andrew-davie/NBTV/README.md

# NBTV
Source code for Arduino Micro Mechanical Television
see https://www.taswegian.com/NBTV/forum/viewforum.php?f=28
