andrew-davie/NBTV/src/tv2d.brd

## EAGLE design src/tv2d.brd (2017-06-04)

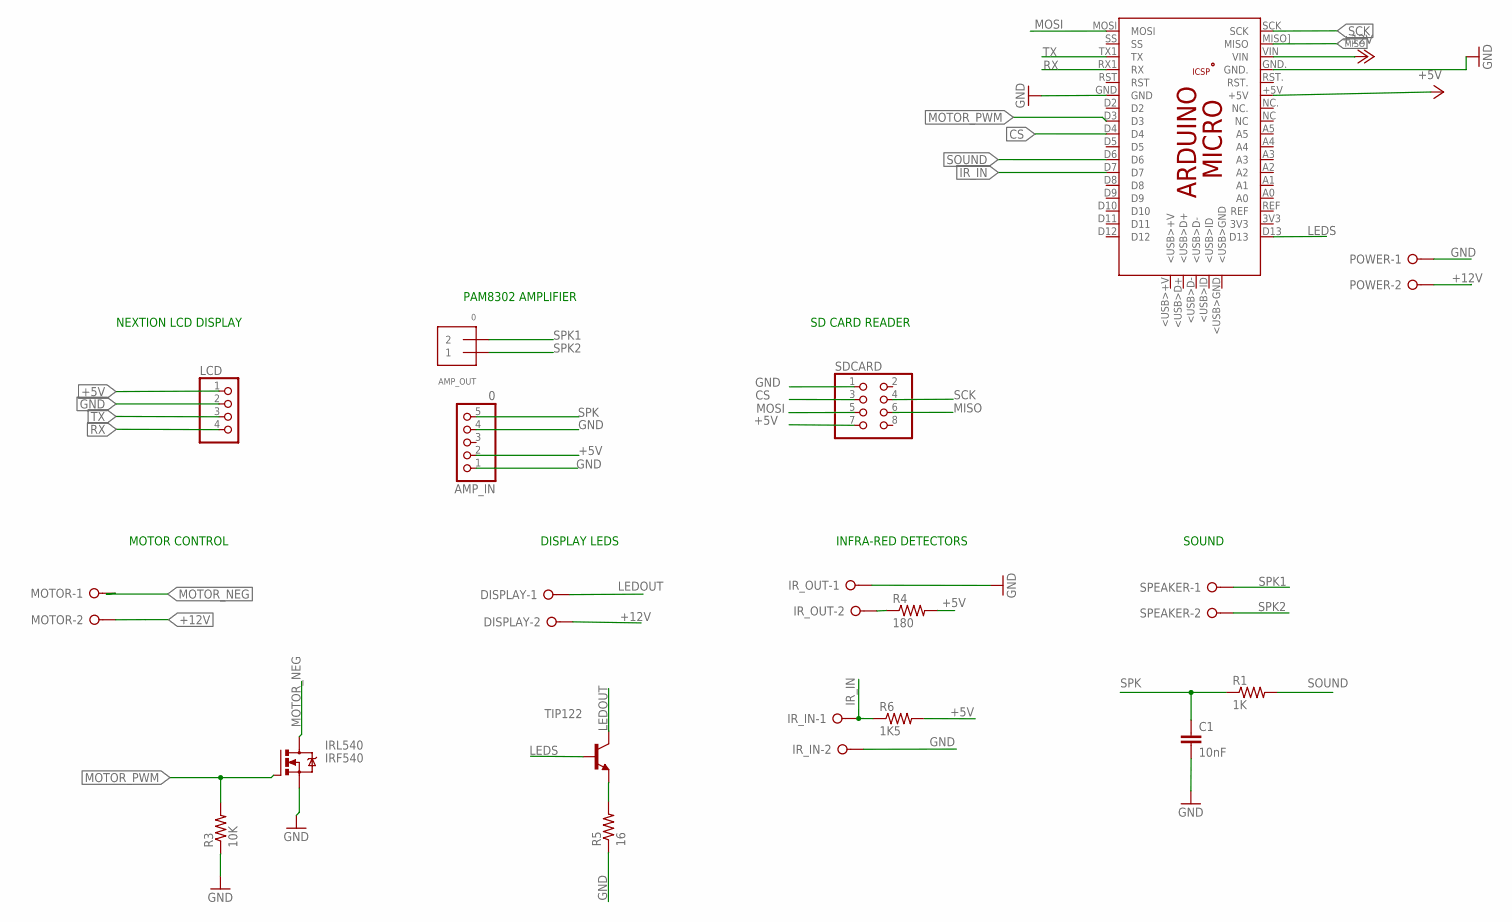
[picture p1: schematic tv2d.sch]

Parts:
AMP_IN: 0; 1X05_ROUND_70
AMP_OUT: 0; TERMBLOCK_1X2-3.5MM
C1: 10nF; C2.5-2
DISPLAY: W237-02P; W237-132
IRL540: IRF540; TO220BV
IR_IN: W237-02P; W237-132
IR_OUT: W237-02P; W237-132
LCD: PINHD-1X4; 1X04
MOTOR: W237-02P; W237-132
PCB1: ARDUINO_MICRO
POWER: W237-02P; W237-132
R1: 1K; 0207/10
R3: 10K; 0207/10
R4: 180; 0207/10
R5: 16; 0207/10
R6: 1K5; 0207/10
SDCARD: PINHD-2X4; 2X04
SPEAKER: W237-02P; W237-132
TIP122: -NPN-TO220V; TO220V

Connections:
+5V: AMP_IN.2, LCD.1, PCB1.+5V, R4.2, R6.2, SDCARD.7
+12V: DISPLAY.2, MOTOR.2, PCB1.VIN, POWER.2
CS: PCB1.D4, SDCARD.3
GND: AMP_IN.1, AMP_IN.4, C1.2, IRL540.S, IR_IN.2, IR_OUT.1, LCD.2, PCB1.GND, PCB1.GND., POWER.1, R3.1, R5.1, SDCARD.1
IR_IN: IR_IN.1, PCB1.D7, R6.1
IR_OUT: IR_OUT.2, R4.1
LEDOUT: DISPLAY.1, TIP122.2 (C)
LEDS: PCB1.D13, TIP122.1 (B)
MISO: PCB1.MISO] (MISO), SDCARD.6
MOSI: PCB1.MOSI, SDCARD.5
MOTOR_NEG: IRL540.D, MOTOR.1
MOTOR_PWM: IRL540.G, PCB1.D3, R3.2
unnamed: R5.2, TIP122.3 (E)
RX: LCD.4, PCB1.RX1 (RX)
SCK: PCB1.SCK, SDCARD.4
SOUND: PCB1.D6, R1.2
SPK: AMP_IN.5, C1.1, R1.1
SPK1: AMP_OUT.2, SPEAKER.1
SPK2: AMP_OUT.1, SPEAKER.2
TX: LCD.3, PCB1.TX1 (TX)

Notes on the sheet:
MOTOR CONTROL
DISPLAY LEDS
INFRA-RED DETECTORS
NEXTION LCD DISPLAY
PAM8302 AMPLIFIER
SD CARD READER
SOUND

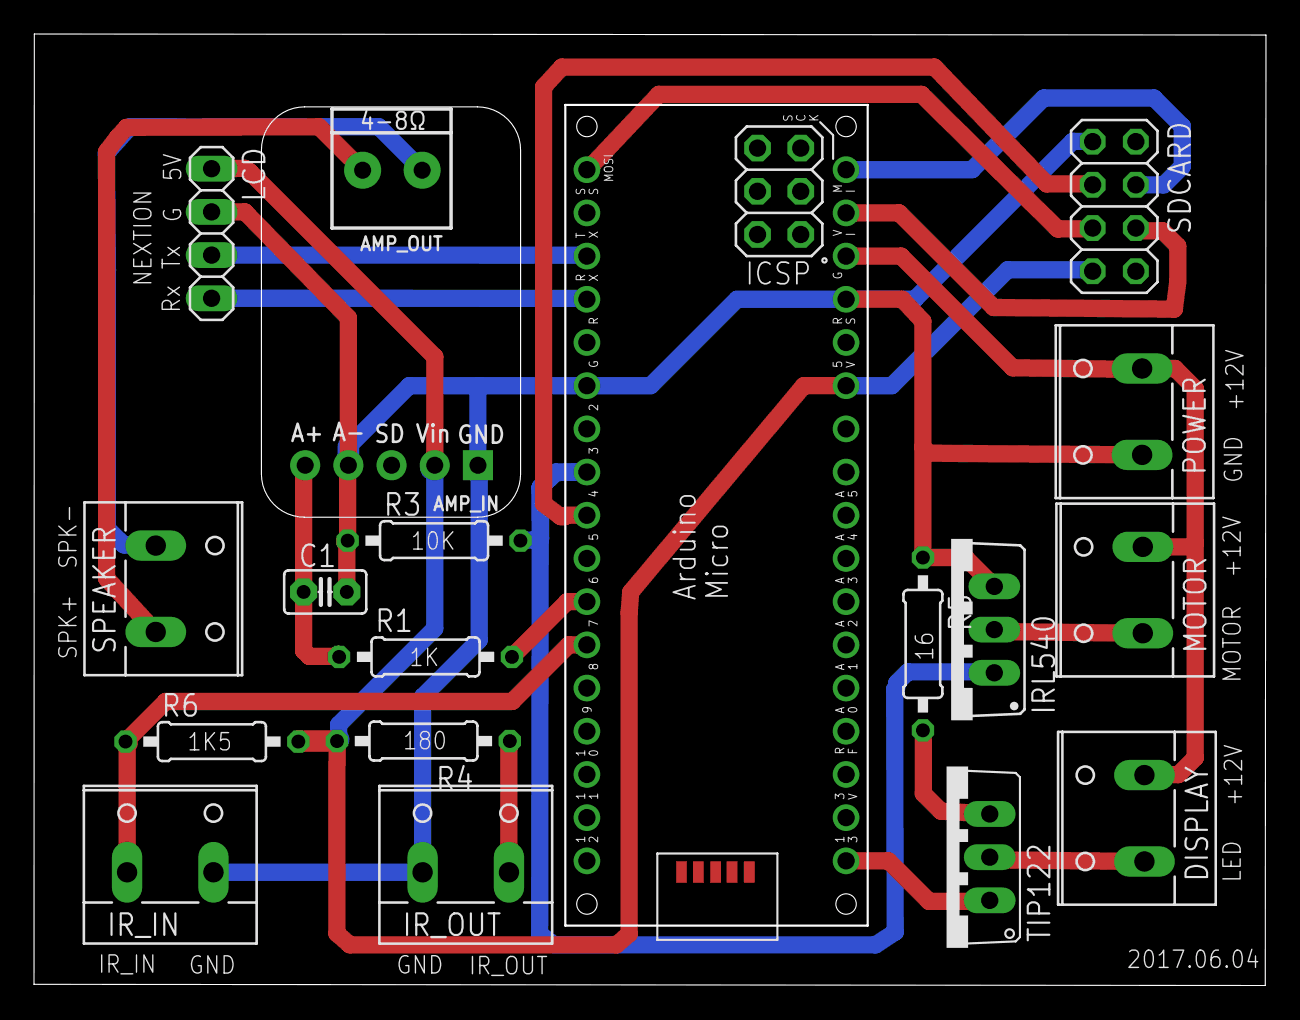
[picture p2: board tv2d.brd from above]

Board: 2 copper layers, 72.4 x 55.9 mm, 19 parts (0 on the bottom side), 20 nets.
