andrew-davie/NBTV/src/tvp3.brd

## EAGLE design src/tvp3.brd (2017-07-02)

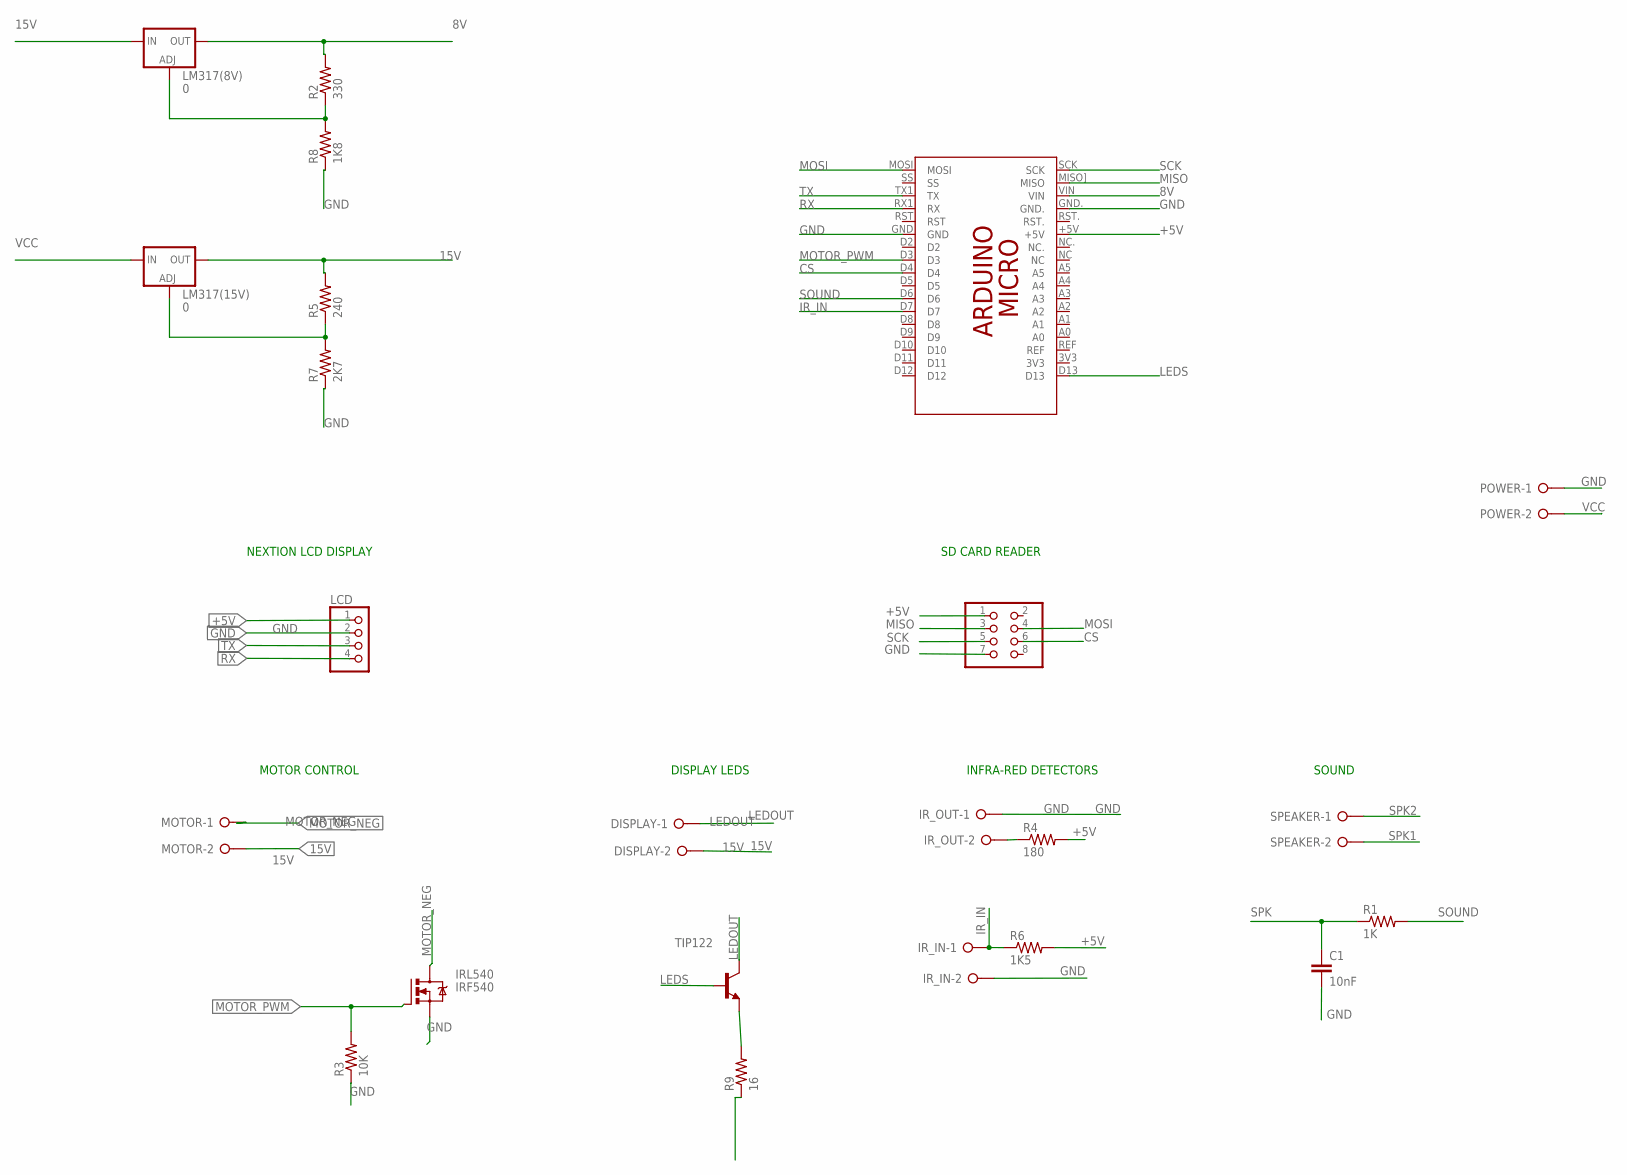
[picture p3: schematic tvp3.sch, sheet 1]

Parts:
C1: 10nF; C2.5-2
DISPLAY: W237-02P; W237-132
IRL540: IRF540; TO220BV
IR_IN: W237-02P; W237-132
IR_OUT: W237-02P; W237-132
LCD: PINHD-1X4; 1X04
LM317(8V), LM317(15V): 0; 317TS
MOTOR: W237-02P; W237-132
PCB2: ARDUINO_MICRO
POWER: W237-02P; W237-132
R1: 1K; 0207/10
R2: 330; 0207/10
R3: 10K; 0207/10
R4: 180; 0207/10
R5: 240; 0207/10
R6: 1K5; 0207/10
R7: 2K7; 0207/10
R8: 1K8; 0207/10
R9: 16; 0207/10
SPEAKER: W237-02P; W237-132
TIP122: -NPN-TO220V; TO220V
_: PINHD-2X4; 2X04

Connections:
8V: LM317(8V).2 (OUT), PCB2.VIN, R2.2
15V: DISPLAY.2, LM317(8V).3 (IN), LM317(15V).2 (OUT), MOTOR.2, R5.2
+5V: LCD.1, PCB2.+5V, R4.2, R6.2, _.1; also elsewhere on the board
CS: PCB2.D4, _.6
GND: C1.2, IRL540.S, IR_IN.2, IR_OUT.1, LCD.2, PCB2.GND, PCB2.GND., POWER.1, R3.1, R7.1, R8.1, R9.1, _.7; also elsewhere on the board
IR_IN: IR_IN.1, PCB2.D7, R6.1
IR_OUT: IR_OUT.2, R4.1
LEDOUT: DISPLAY.1, TIP122.2 (C)
LEDS: PCB2.D13, TIP122.1 (B)
MISO: PCB2.MISO] (MISO), _.3
MOSI: PCB2.MOSI, _.4
MOTOR_NEG: IRL540.D, MOTOR.1
MOTOR_PWM: IRL540.G, PCB2.D3, R3.2
unnamed: LM317(15V).1 (ADJ), R5.1, R7.2
unnamed: R9.2, TIP122.3 (E)
unnamed: LM317(8V).1 (ADJ), R2.1, R8.2
RX: LCD.4, PCB2.RX1 (RX)
SCK: PCB2.SCK, _.5
SOUND: PCB2.D6, R1.2
SPK: C1.1, R1.1; also elsewhere on the board
SPK1: SPEAKER.2; also elsewhere on the board
SPK2: SPEAKER.1; also elsewhere on the board
TX: LCD.3, PCB2.TX1 (TX)
VCC: LM317(15V).3 (IN), POWER.2

Notes on the sheet:
MOTOR CONTROL
DISPLAY LEDS
INFRA-RED DETECTORS
NEXTION LCD DISPLAY
SD CARD READER
SOUND

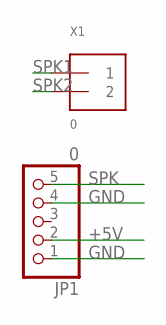
[picture p4: schematic tvp3.sch, sheet 2]

Parts:
JP1: 0; 1X05_ROUND_70
X1: 0; TERMBLOCK_1X2-3.5MM

Connections:
+5V: JP1.2; also elsewhere on the board
GND: JP1.1, JP1.4; also elsewhere on the board
SPK: JP1.5; also elsewhere on the board
SPK1: X1.1; also elsewhere on the board
SPK2: X1.2; also elsewhere on the board

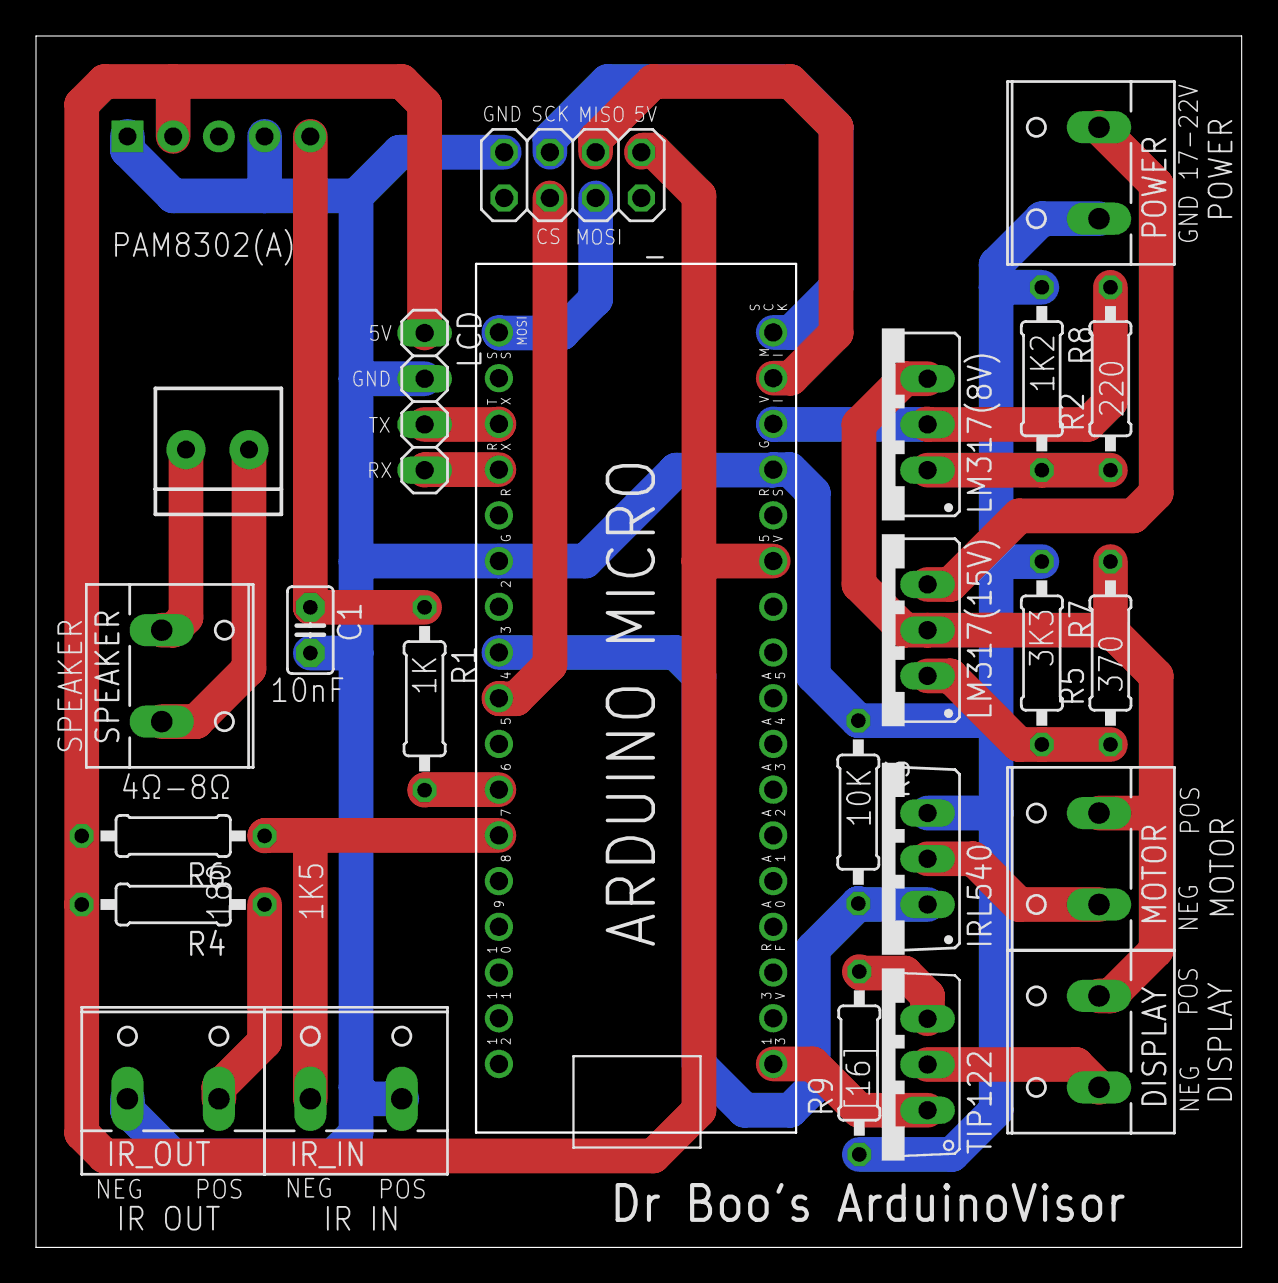
[picture p5: board tvp3.brd from above]

Board: 2 copper layers, 67.0 x 67.3 mm, 25 parts (0 on the bottom side), 24 nets.
