andrew-davie/NBTV/(commit log)

2017-03-25 let's get serious
    CIrcular streaming audio/video buffer implemented to reduce memory footprint
    my televisor is "pulling" and there must be a motor or disc bearing problem.
    PID operational but hardly able to resist the disturbance
    video streaming basically OK but occasonal glitching so there's a bug there somewhere
    SD card streaming good, but need a super-fast card, as we can't afford delays/lag
    rudimentary televisor operates OK off this code
    [televisor.h]
2017-04-05 some work on the Nextion interface
    lots of optimisation to reduce ram/memory
    fixed an off-by-one bug in the video playback (explains a few things)
    Nextion support works but clashes with playback - one or the other at the moment
    memory is short (RAM). May need to customise the libraries
    [televisor.h]
2017-04-06 UI functional
    Moved video buffer stuffer to an interrupt, freeing up the main loop which now does the serial comms to the Nextion. This update has the 'brightness' control functional, taking slider values from the nextion LCD and changing the video brightness on the fly.
2017-04-10 functional frame lock
    First version demonstrating frame lock. Very slow and sensitive, but working!
2017-04-14 "solved" nextion RAM problem
    see NextionUI.cpp for comments - there appears to be an Arduino IDE linker problem.
    [televisor.h]
2017-04-16 rationalisation
    Bug regarding circular buffer size - seems to occur when streaming from SD in chunks >64 bytes. Could be an overlap/clash in serial...?
    [televisor.h]
2017-04-17 consolidated to a single file + PID library
2017-04-21 PID working for 12.5Hz disc speed lock
2017-04-22 pixel-perfect framer!
    See https://www.youtube.com/watch?v=zXrc1Xl-fEc
2017-05-12 start/stop of tracks now working and synch correct
    Complete playback function now working with correct track synch and start/stop of motor and interrupts.
2017-05-21 clean, nearly complete
    Couple of issues
    * seeker not working properly
    * shifter not working properly
    This commit has cleaned up the TFT file a lot and managing the switching between INFO/SHIFT screen nicely
2017-06-04 eagle files for stand-alone circuit board
    Untested as yet! I'm also learning how to use Eagle, so it might be a bit weird in places :)
    [tv2d.brd, tv2d.sch]
2017-06-16 eagle board/schematic for LED matrix display
2017-06-16 stand-alone
    This version will play all files on the SD card, in the case where NO Nextion is included
    That is, when NEXTION is not defined in the code - the televisor will still play stuff
2017-06-16 sample NBTV8-format file for playback
    Doctor Who episode, complete, in NBTV8 format
    also includes accompanying info file for UI display
2017-07-02 added new circuit board
    Version 2 of circuit board
    [tvp3.brd, tvp3.sch]
2017-08-06 moved to Atom IDE
    some updates to fix sound 'popping'
    code now run through auto-formatter
    [televisor.cpp]
2017-10-17 optimisations
    Completely untested! Could be broken. Just wanted to get this stage captured for posterity.
    There seemed to be a bug in the seek, which I've fixed. No idea how it managed to work before - but *actually* I realised this may actually explain the half-frame issue I'vebeen seeing after seeking. Let's see if that is gone.
    [nex.h, televisor.cpp, televisor.h]
2017-10-17 optimisatoin
    dumb me updated the files to the root directory before. These are now correct.
    Many optimisations, completely untested.
    One major bug found (?) in the seeking - perhaps this explains the half-frames I've occasionally seen. The header size was not taken into account when seeking, so it would have been "out" by that amount.
    [nex.h, televisor.cpp, televisor.h]
2017-10-19 fixed the broken sound. hopefully.
    Just did a diff, not sure what actually fixed the sound. Appears to work.
    [televisor.cpp]
2017-10-19 optimisation
    Removed volatiles. Seems to make no difference, except for hundreds of bytes saved.
    Some speedups in the playback interrupt. Used smaller type for audio.
2017-10-20 optimisations
    saved some memory. playback interrupt slightly quicker.
